kanaya/Pineapple_II_Nitrogen/Hardware/Panel/Takachi-Order-Sheet.pdf

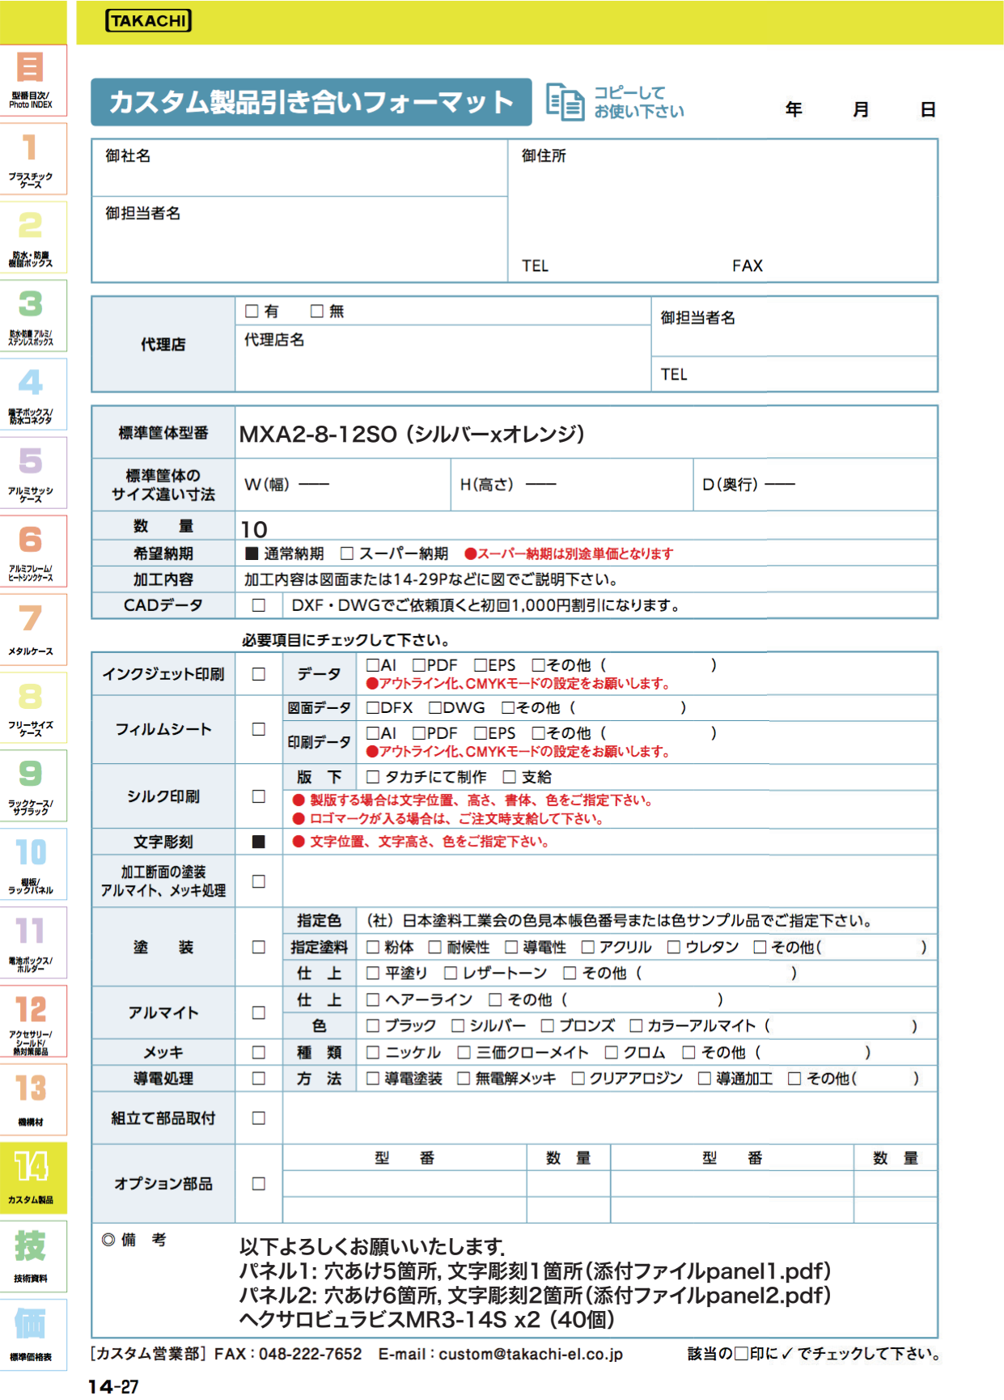
[picture p1: page 1]

MXA2-8-12SO （シルバーxオレンジ）

10

––– | ––– | –––

以下よろしくお願いいたします．
パネル1: 穴あけ5箇所，文字彫刻1箇所（添付ファイルpanel1.pdf） パネル2: 穴あけ6箇所，文字彫刻2箇所（添付ファイルpanel2.pdf） ヘクサロビュラビスMR3-14S x2 （40個）
