kanaya/Pineapple_II_Nitrogen/Hardware/Panel/panel-layout.pdf

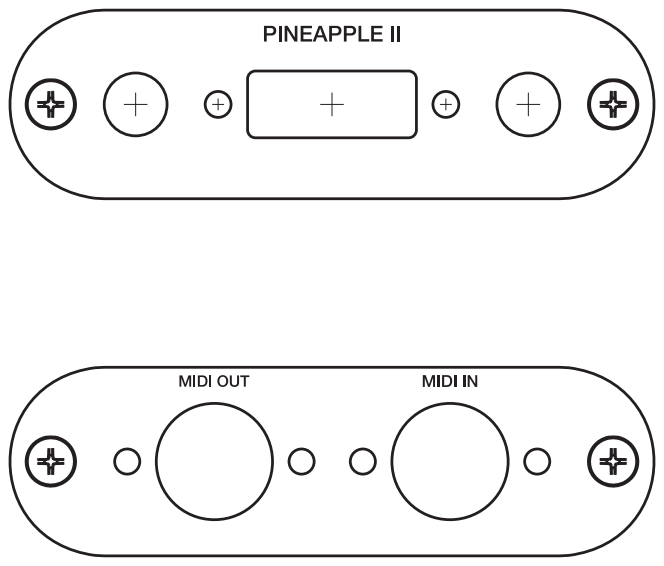
[picture p2: page 1]
