kanaya/Pineapple_II_Nitrogen/Hardware/Panel/panel1.pdf

## BLACK

## PANEL 1

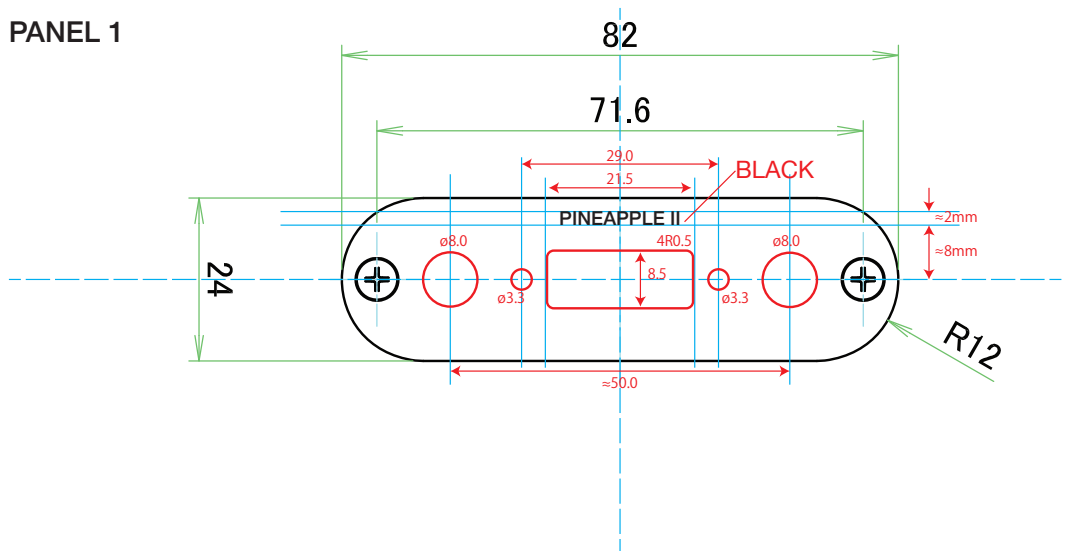
[picture p3: page 1]
PINEAPPLE II
