kanaya/Pineapple_II_Nitrogen/Hardware/Panel/panel2.pdf

BLACK | BLACK

## PANEL 2

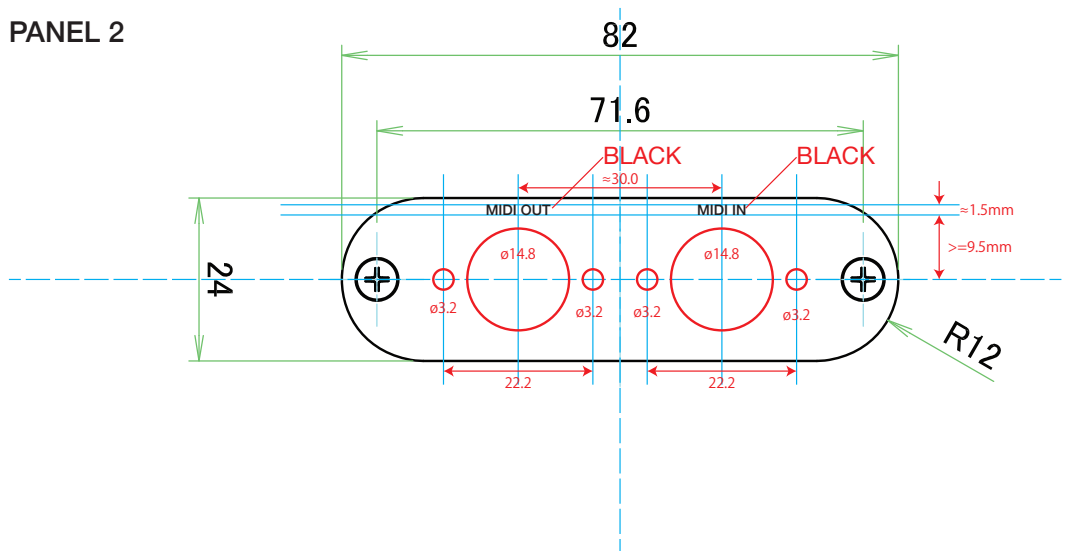
[picture p4: page 1]
MIDI OUT; MIDI IN
