kanaya/Pineapple_II_Nitrogen/Hardware/Board/P2N-001.brd

## EAGLE design Hardware/Board/P2N-001.brd (2015-04-24)

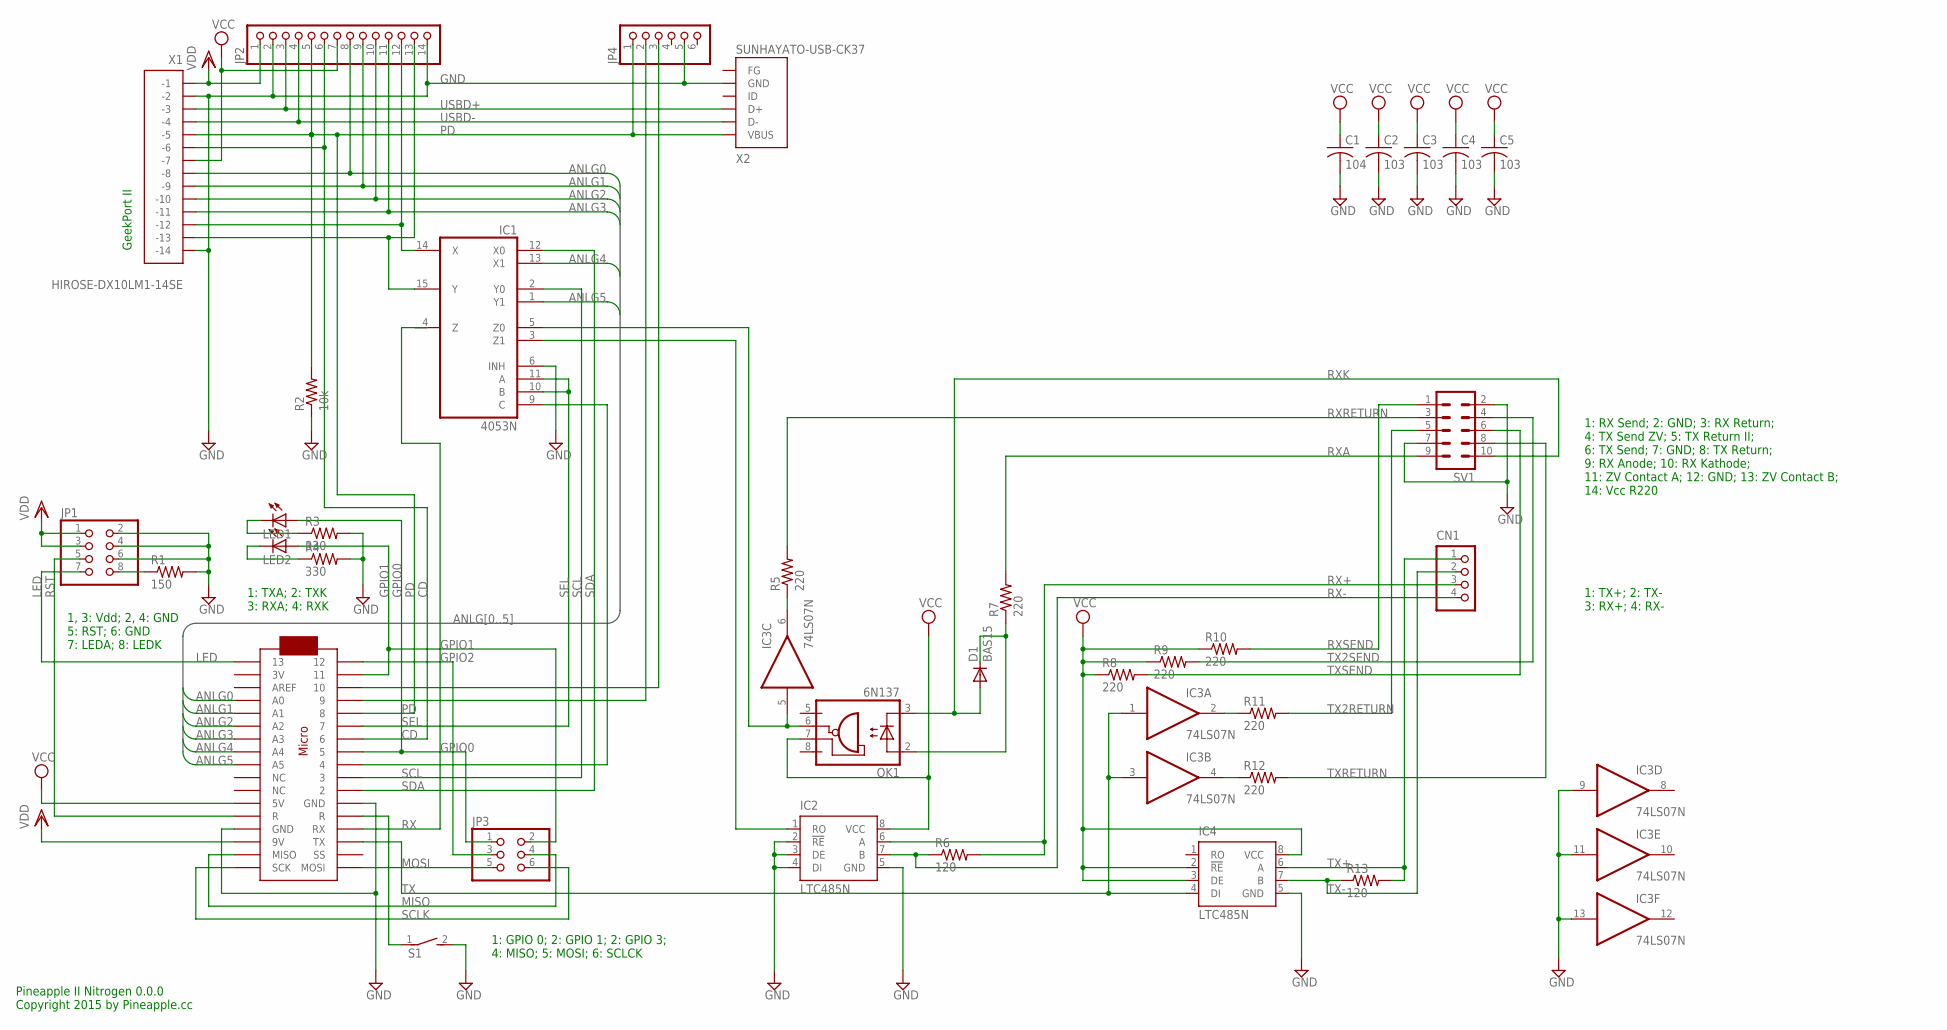
[picture p5: schematic P2N-001.sch]

Parts:
C1: 104; C025-025X050
C2, C3, C4, C5: 103; C025-025X050
CN1: S4B-PH-K-S
D1: BAS15; DO34-7
IC1: 4053N; DIL16
IC2, IC4: LTC485N; DIL08
IC3: 74LS07N; DIL14
JP1: PINHD-2X4; 2X04
JP2: PINHD-1X14-CB; 1X14-CB
JP3: PINHD-2X3; 2X03
JP4: PINHD-1X6; 1X06
LED1, LED2: LED3MM
MC1: ARDUINOMICRO
OK1: 6N137; DIL08
R1: 150; 0204/5
R2: 10k; 0204/5
R3, R4: 330; 0204/5
R5, R7, R8, R9, R10, R11, R12: 220; 0204/5
R6, R13: 120; 0204/5
S1: DS01E; DS-01
SV1: ML10L
X1: HIROSE-DX10LM1-14SE
X2: SUNHAYATO-USB-CK37

Connections:
ANLG0: JP2.8, MC1.P$31 (A0), X1.P$8 (-8)
ANLG1: JP2.9, MC1.P$30 (A1), X1.P$9 (-9)
ANLG2: JP2.10, MC1.P$29 (A2), X1.P$10 (-10)
ANLG3: JP2.11, MC1.P$28 (A3), X1.P$11 (-11)
ANLG4: IC1.13 (X1), MC1.P$27 (A4)
ANLG5: IC1.1 (Y1), MC1.P$26 (A5)
CD: JP2.6, MC1.P$7 (6), X1.P$6 (-6)
GND: C1.2, C2.2, C3.2, C4.2, C5.2, IC1.6 (INH), IC1.8 (GND), IC2.2 (!RE), IC2.3 (DE), IC2.4 (DI), IC2.5 (GND), IC3.7 (GND), IC3.9 (I), IC3.11 (I), IC3.13 (I), IC4.5 (GND), JP1.2, JP1.4, JP1.6, JP2.2, JP2.14, JP4.5, MC1.P$12 (GND), MC1.P$21 (GND), R1.2, R2.1, R3.2, R4.2, S1.2, SV1.2, SV1.7, X1.P$2 (-2), X1.P$14 (-14), X2.P$5 (GND)
GPIO0: JP3.1, LED1.A, MC1.P$8 (5)
GPIO1: JP3.2, LED2.A, MC1.P$2 (11)
GPIO2: JP3.3, MC1.P$1 (12)
LED: JP1.7, MC1.P$34 (13)
MIDIRX: IC1.5 (Z0), IC3.5 (I), OK1.6 (VO)
MISO: JP3.4, MC1.P$19 (MISO)
MOSI: JP3.5, MC1.P$17 (MOSI)
unnamed: MC1.P$22 (R), S1.1
unnamed: IC3.2 (O), R11.1
unnamed: IC3.6 (O), R5.1
unnamed: IC3.4 (O), R12.1
unnamed: JP4.2, MC1.P$4 (9)
unnamed: JP4.3, MC1.P$3 (10)
unnamed: IC1.9 (C), MC1.P$9 (4)
unnamed: D1.C, OK1.2 (A), R7.1
unnamed: LED1.K (C), R3.1
unnamed: LED2.K (C), R4.1
unnamed: IC1.14 (X), JP2.12, X1.P$12 (-12)
unnamed: IC1.15 (Y), JP2.13, X1.P$13 (-13)
unnamed: JP1.8, R1.1
PD: JP2.5, JP4.1, MC1.P$5 (8), R2.2, X1.P$5 (-5), X2.P$1 (VBUS)
RST: JP1.5, MC1.P$13 (R)
RX: MC1.P$14 (RX)
RX+: CN1.3, IC2.6 (A), R6.2
RX-: CN1.4, IC2.7 (B), R6.1
RXA: R7.2, SV1.9
RXK: D1.A, OK1.3 (C), SV1.10
RXRETURN: R5.2, SV1.3
RXSEND: R10.2, SV1.1
SCL: IC1.2 (Y0), MC1.P$10 (3)
SCLK: JP3.6, MC1.P$18 (SCK)
SDA: IC1.12 (X0), MC1.P$11 (2)
SEL: IC1.10 (B), IC1.11 (A), MC1.P$6 (7)
TX: IC3.1 (I), IC3.3 (I), IC4.4 (DI), MC1.P$15 (TX)
TX2RETURN: R11.2, SV1.5
TX2SEND: R9.2, SV1.4
TX+: CN1.1, IC4.6 (A), R13.2
TX-: CN1.2, IC4.7 (B), R13.1
TXRETURN: R12.2, SV1.8
TXSEND: R8.2, SV1.6
USBD+: JP2.3, X1.P$3 (-3), X2.P$3 (D+)
USBD-: JP2.4, X1.P$4 (-4), X2.P$2 (D-)
VCC: C1.1, C2.1, C3.1, C4.1, C5.1, IC1.16 (VCC), IC2.8 (VCC), IC3.14 (VCC), IC4.2 (!RE), IC4.3 (DE), IC4.8 (VCC), JP2.7, MC1.P$23 (5V), OK1.7 (VE), R8.1, R9.1, R10.1, X1.P$7 (-7)
VDD: JP1.1, JP1.3, JP2.1, MC1.P$20 (9V), X1.P$1 (-1)
VEE: IC1.7 (VEE)
XMIDIRX: IC1.3 (Z1), IC2.1 (RO)

Notes on the sheet:
Pineapple II Nitrogen 0.0.0 Copyright 2015 by Pineapple.cc
1, 3: Vdd; 2, 4: GND 5: RST; 6: GND 7: LEDA; 8: LEDK
GeekPort II
1: TXA; 2: TXK 3: RXA; 4: RXK
1: TX+; 2: TX- 3: RX+; 4: RX-
1: GPIO 0; 2: GPIO 1; 2: GPIO 3; 4: MISO; 5: MOSI; 6: SCLCK
1: RX Send; 2: GND; 3: RX Return; 4: TX Send ZV; 5: TX Return II; 6: TX Send; 7: GND; 8: TX Return; 9: RX Anode; 10: RX Kathode; 11: ZV Contact A; 12: GND; 13: ZV Contact B; 14: Vcc R220

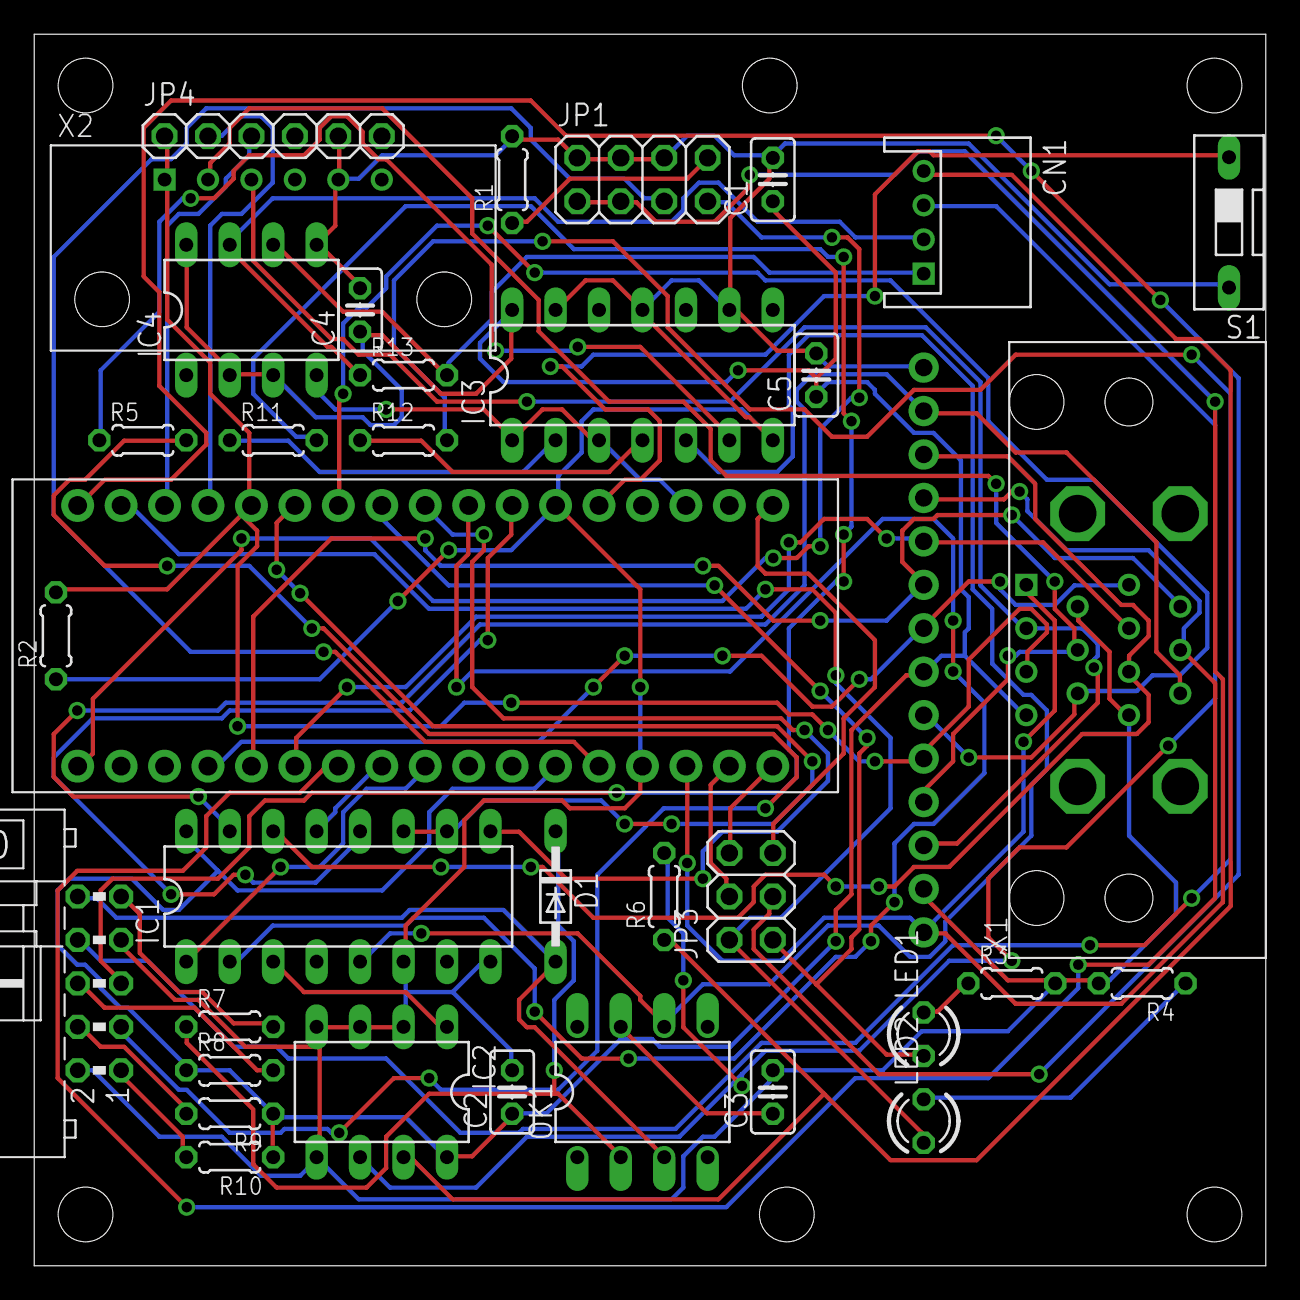
[picture p6: board P2N-001.brd from above]

Board: 2 copper layers, 72.0 x 72.0 mm, 36 parts (0 on the bottom side), 52 nets.
