kanaya/Pineapple_II_Nitrogen/Hardware/Board/P2N15-001.brd

## EAGLE design Hardware/Board/P2N15-001.brd (2015-04-24)

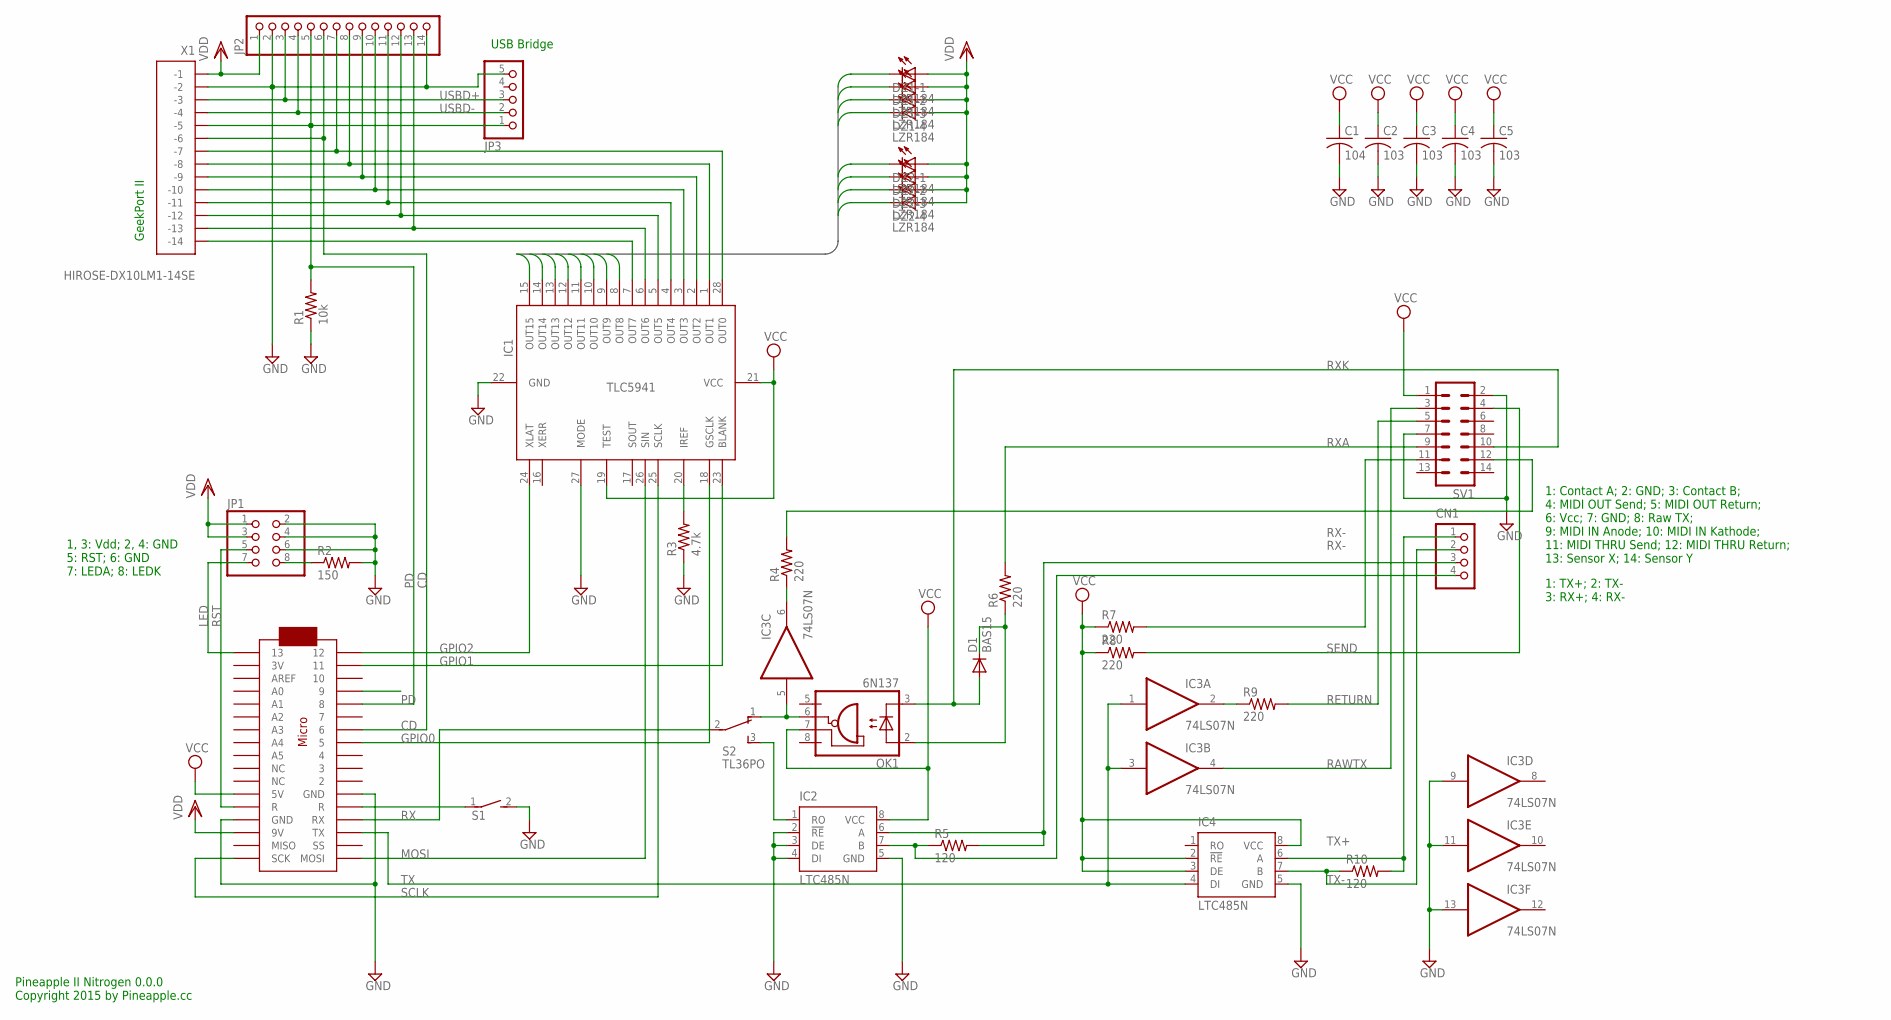
[picture p7: schematic P2N15-001.sch]

Parts:
C1: 104; C025-025X050
C2, C3, C4, C5: 103; C025-025X050
CN1: S4B-PH-K-S
D1: BAS15; DO34-7
DZ1, DZ2: LZR184
IC1: TLC5941NT; DIL28-3
IC2, IC4: LTC485N; DIL08
IC3: 74LS07N; DIL14
JP1: PINHD-2X4; 2X04
JP2: PINHD-1X14; 1X14
JP3: PINHD-1X5/90; 1X05/90
MC1: ARDUINOMICRO
OK1: 6N137; DIL08
R1: 10k; 0204/5
R2: 150; 0204/5
R3: 4.7k; 0204/5
R4, R6, R7, R8, R9: 220; 0204/5
R5, R10: 120; 0204/5
S1: DS01E; DS-01
S2: TL36PO; TL3XPO
SV1: ML14L
X1: HIROSE-DX10LM1-14SE

Connections:
ANLG0: IC1.1 (OUT1), JP2.8, X1.P$8 (-8)
ANLG1: IC1.2 (OUT2), JP2.9, X1.P$9 (-9)
ANLG2: IC1.3 (OUT3), JP2.10, X1.P$10 (-10)
ANLG3: IC1.4 (OUT4), JP2.11, X1.P$11 (-11)
CD: JP2.6, MC1.P$7 (6), X1.P$6 (-6)
GND: C1.2, C2.2, C3.2, C4.2, C5.2, IC1.22 (GND), IC1.27 (MODE), IC2.2 (!RE), IC2.3 (DE), IC2.4 (DI), IC2.5 (GND), IC3.7 (GND), IC3.9 (I), IC3.11 (I), IC3.13 (I), IC4.5 (GND), JP1.2, JP1.4, JP1.6, JP2.2, JP2.14, JP3.5, MC1.P$12 (GND), MC1.P$21 (GND), R1.1, R2.2, R3.1, S1.2, SV1.2, SV1.7, X1.P$2 (-2)
GPIO0: IC1.18 (GSCLK), MC1.P$8 (5)
GPIO1: IC1.23 (BLANK), MC1.P$2 (11)
GPIO2: IC1.24 (XLAT), MC1.P$1 (12)
LED: JP1.7, MC1.P$34 (13)
LED0: DZ1.K1 (C), IC1.8 (OUT8)
LED1: DZ1.K2 (C), IC1.9 (OUT9)
LED2: DZ1.K3 (C), IC1.10 (OUT10)
LED3: DZ1.K4 (C), IC1.11 (OUT11)
LED4: DZ2.K1 (C), IC1.12 (OUT12)
LED5: DZ2.K2 (C), IC1.13 (OUT13)
LED6: DZ2.K3 (C), IC1.14 (OUT14)
LED7: DZ2.K4 (C), IC1.15 (OUT15)
MIDIRX: IC3.5 (I), OK1.6 (VO), S2.1 (O)
MOSI: IC1.26 (SIN), MC1.P$17 (MOSI)
unnamed: IC1.28 (OUT0), JP2.7, X1.P$7 (-7)
unnamed: IC3.2 (O), R9.1
unnamed: IC1.20 (IREF), R3.2
unnamed: MC1.P$22 (R), S1.1
unnamed: IC3.6 (O), R4.1
unnamed: R7.2, SV1.11
unnamed: IC1.7 (OUT7), X1.P$14 (-14)
unnamed: R4.2, SV1.12
unnamed: D1.C, OK1.2 (A), R6.1
unnamed: IC1.5 (OUT5), JP2.12, X1.P$12 (-12)
unnamed: IC1.6 (OUT6), JP2.13, X1.P$13 (-13)
unnamed: JP1.8, R2.1
PD: JP2.5, JP3.1, MC1.P$5 (8), R1.2, X1.P$5 (-5)
RAWTX: IC3.4 (O), SV1.3
RETURN: R9.2, SV1.5
RST: JP1.5, MC1.P$13 (R)
RX: MC1.P$14 (RX), S2.2
RX+: CN1.3, IC2.6 (A), R5.2
RX-: CN1.4, IC2.7 (B), R5.1
RXA: R6.2, SV1.9
RXK: D1.A, OK1.3 (C), SV1.10
SCLK: IC1.25 (SCLK), MC1.P$18 (SCK)
SEND: R8.2, SV1.4
TX: IC3.1 (I), IC3.3 (I), IC4.4 (DI), MC1.P$15 (TX)
TX+: CN1.1, IC4.6 (A), R10.2
TX-: CN1.2, IC4.7 (B), R10.1
USBD+: JP2.3, JP3.3, X1.P$3 (-3)
USBD-: JP2.4, JP3.2, X1.P$4 (-4)
VCC: C1.1, C2.1, C3.1, C4.1, C5.1, IC1.19 (TEST), IC1.21 (VCC), IC2.8 (VCC), IC3.14 (VCC), IC4.2 (!RE), IC4.3 (DE), IC4.8 (VCC), MC1.P$23 (5V), OK1.7 (VE), R7.1, R8.1, SV1.1
VDD: DZ1.A1 (A), DZ1.A2 (A), DZ1.A3 (A), DZ1.A4 (A), DZ2.A1 (A), DZ2.A2 (A), DZ2.A3 (A), DZ2.A4 (A), JP1.1, JP1.3, JP2.1, MC1.P$20 (9V), X1.P$1 (-1)
XMIDIRX: IC2.1 (RO), S2.3 (S)

Notes on the sheet:
Pineapple II Nitrogen 0.0.0 Copyright 2015 by Pineapple.cc
1, 3: Vdd; 2, 4: GND 5: RST; 6: GND 7: LEDA; 8: LEDK
GeekPort II
USB Bridge
1: TX+; 2: TX- 3: RX+; 4: RX-
1: Contact A; 2: GND; 3: Contact B; 4: MIDI OUT Send; 5: MIDI OUT Return; 6: Vcc; 7: GND; 8: Raw TX; 9: MIDI IN Anode; 10: MIDI IN Kathode; 11: MIDI THRU Send; 12: MIDI THRU Return; 13: Sensor X; 14: Sensor Y

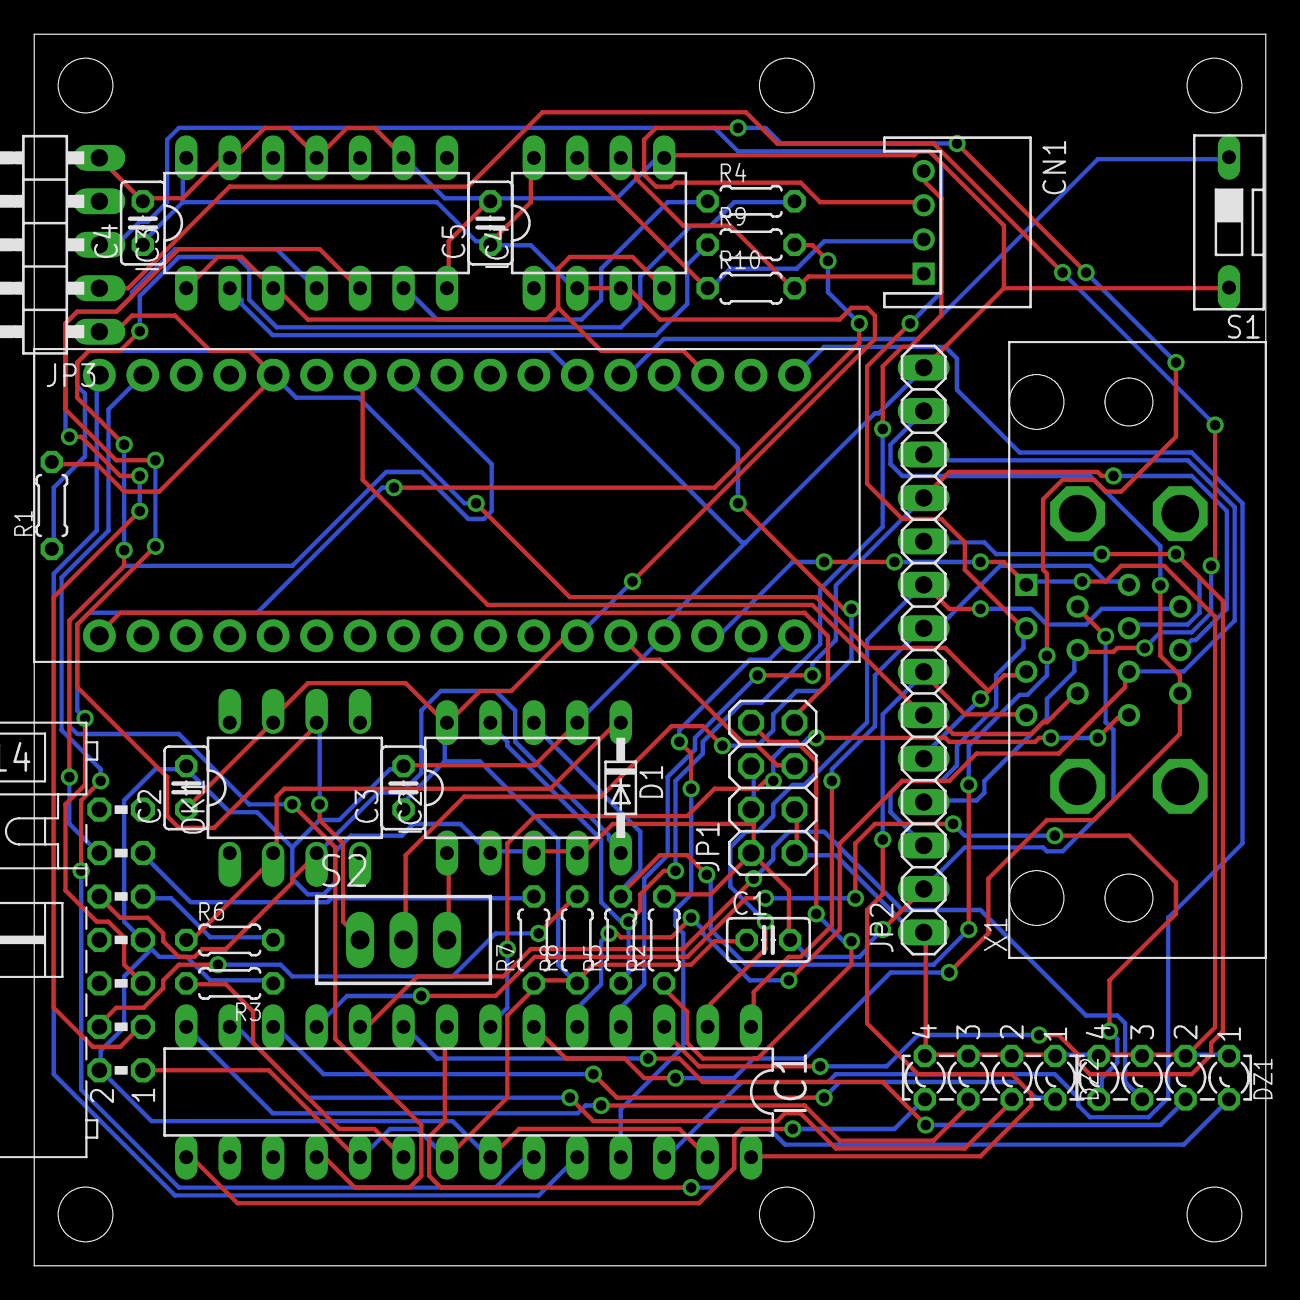
[picture p8: board P2N15-001.brd from above]

Board: 2 copper layers, 72.0 x 72.0 mm, 32 parts (0 on the bottom side), 51 nets.
