kanaya/Pineapple_II_Nitrogen/Hardware/Board/P2N-002.brd

## EAGLE design Hardware/Board/P2N-002.brd (2015-04-14)

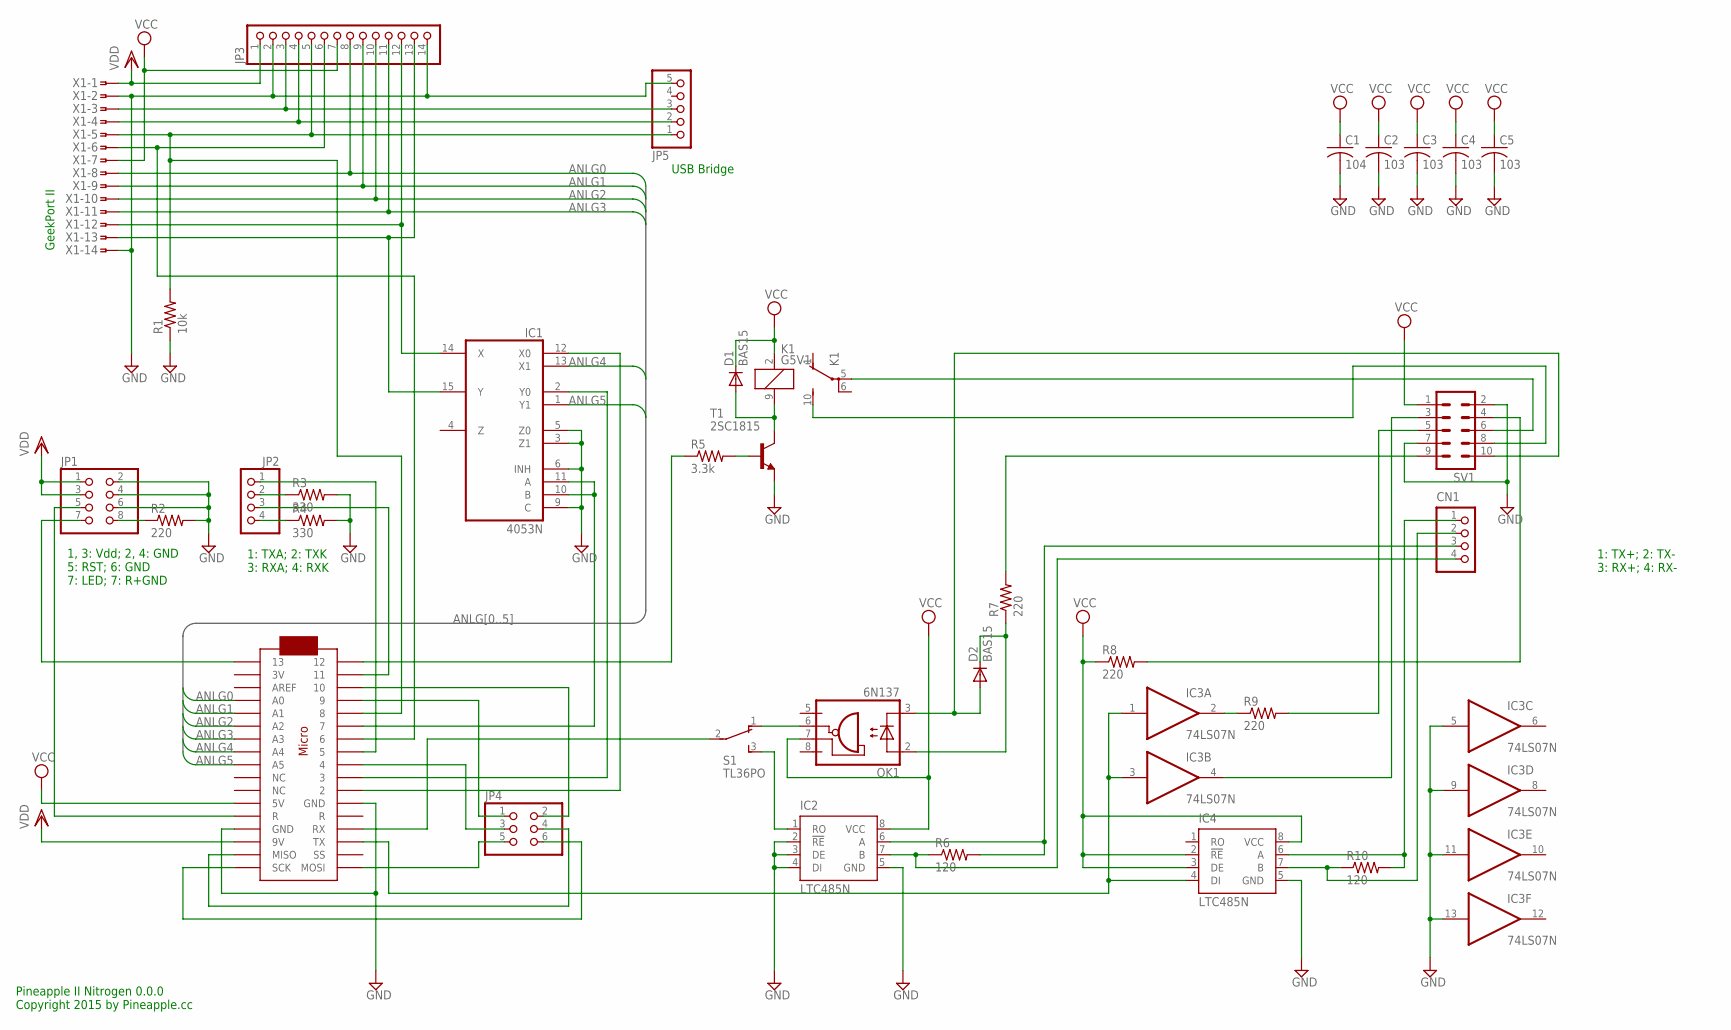
[picture p9: schematic P2N-002.sch]

Parts:
C1: 104; C025-025X050
C2, C3, C4, C5: 103; C025-025X050
CN1: S4B-PH-K-S
D1, D2: BAS15; DO34-7
IC1: 4053N; DIL16
IC2, IC4: LTC485N; DIL08
IC3: 74LS07N; DIL14
JP1: PINHD-2X4; 2X04
JP2: PINHD-1X4; 1X04
JP3: PINHD-1X14; 1X14
JP4: PINHD-2X3; 2X03
JP5: PINHD-1X5/90; 1X05/90
K1: G5V1
MC1: ARDUINOMICRO
OK1: 6N137; DIL08
R1: 10k; 0204/5
R2, R7, R8, R9: 220; 0204/5
R3, R4: 330; 0204/5
R5: 3.3k; 0204/5
R6, R10: 120; 0204/5
S1: TL36PO; TL3XPO
SV1: ML10L
T1: 2SC1815; TO92-ECB
X1: HIROSE-DXLM

Connections:
ANLG0: JP3.8, MC1.P$31 (A0), X1.8
ANLG1: JP3.9, MC1.P$30 (A1), X1.9
ANLG2: JP3.10, MC1.P$29 (A2), X1.10
ANLG3: JP3.11, MC1.P$28 (A3), X1.11
ANLG4: IC1.13 (X1), MC1.P$27 (A4)
ANLG5: IC1.1 (Y1), MC1.P$26 (A5)
GEEK16: IC1.10 (B), IC1.11 (A), MC1.P$6 (7)
GND: C1.2, C2.2, C3.2, C4.2, C5.2, IC1.3 (Z1), IC1.5 (Z0), IC1.6 (INH), IC1.8 (GND), IC1.9 (C), IC2.2 (!RE), IC2.3 (DE), IC2.4 (DI), IC2.5 (GND), IC3.5 (I), IC3.7 (GND), IC3.9 (I), IC3.11 (I), IC3.13 (I), IC4.5 (GND), JP1.2, JP1.4, JP1.6, JP3.2, JP3.14, JP5.5, MC1.P$12 (GND), MC1.P$21 (GND), R1.1, R2.2, R3.2, R4.2, SV1.2, SV1.7, T1.E, X1.2, X1.14
MIDI1: CN1.1, IC4.6 (A), R10.2
MIDI3: CN1.2, IC4.7 (B), R10.1
MIDI6: IC3.1 (I), IC3.3 (I), IC4.4 (DI), MC1.P$15 (TX)
MIDI11: CN1.3, IC2.6 (A), R6.2
MIDI13: CN1.4, IC2.7 (B), R6.1
MIDI15: D2.A, OK1.3 (C), SV1.10
MIDIRX: OK1.6 (VO), S1.1 (O)
unnamed: IC3.4 (O), SV1.3
unnamed: IC3.2 (O), R9.1
unnamed: JP1.5, MC1.P$13 (R)
unnamed: JP1.7, MC1.P$34 (13)
unnamed: R7.2, SV1.9
unnamed: D1.A, K1.9 (2), T1.C
unnamed: MC1.P$14 (RX), S1.2
unnamed: R5.2, T1.B
unnamed: JP4.3, MC1.P$9 (4)
unnamed: R9.2, SV1.5
unnamed: JP4.5, MC1.P$17 (MOSI)
unnamed: R8.2, SV1.4
unnamed: JP4.6, MC1.P$18 (SCK)
unnamed: K1.10 (S), SV1.8
unnamed: D2.C, OK1.2 (A), R7.1
unnamed: K1.5, SV1.6
unnamed: JP2.2, R3.1
unnamed: JP2.4, R4.1
unnamed: IC1.2 (Y0), MC1.P$10 (3)
unnamed: JP2.1, MC1.P$8 (5)
unnamed: JP2.3, MC1.P$2 (11)
unnamed: MC1.P$1 (12), R5.1
unnamed: IC1.12 (X0), MC1.P$11 (2)
unnamed: JP3.5, JP5.1, MC1.P$5 (8), R1.2, X1.5
unnamed: JP3.4, JP5.2, X1.4
unnamed: JP3.3, JP5.3, X1.3
unnamed: JP3.6, MC1.P$7 (6), X1.6
unnamed: IC1.14 (X), JP3.12, X1.12
unnamed: IC1.15 (Y), JP3.13, X1.13
unnamed: JP4.1, MC1.P$4 (9)
unnamed: JP4.2, MC1.P$3 (10)
unnamed: JP1.8, R2.1
unnamed: JP4.4, MC1.P$19 (MISO)
VCC: C1.1, C2.1, C3.1, C4.1, C5.1, D1.C, IC1.16 (VCC), IC2.8 (VCC), IC3.14 (VCC), IC4.2 (!RE), IC4.3 (DE), IC4.8 (VCC), JP3.7, K1.2 (1), MC1.P$23 (5V), OK1.7 (VE), R8.1, SV1.1, X1.7
VDD: JP1.1, JP1.3, JP3.1, MC1.P$20 (9V), X1.1
VEE: IC1.7 (VEE)
XMIDIRX: IC2.1 (RO), S1.3 (S)

Notes on the sheet:
Pineapple II Nitrogen 0.0.0 Copyright 2015 by Pineapple.cc
1, 3: Vdd; 2, 4: GND 5: RST; 6: GND 7: LED; 7: R+GND
GeekPort II
USB Bridge
1: TXA; 2: TXK 3: RXA; 4: RXK
1: TX+; 2: TX- 3: RX+; 4: RX-

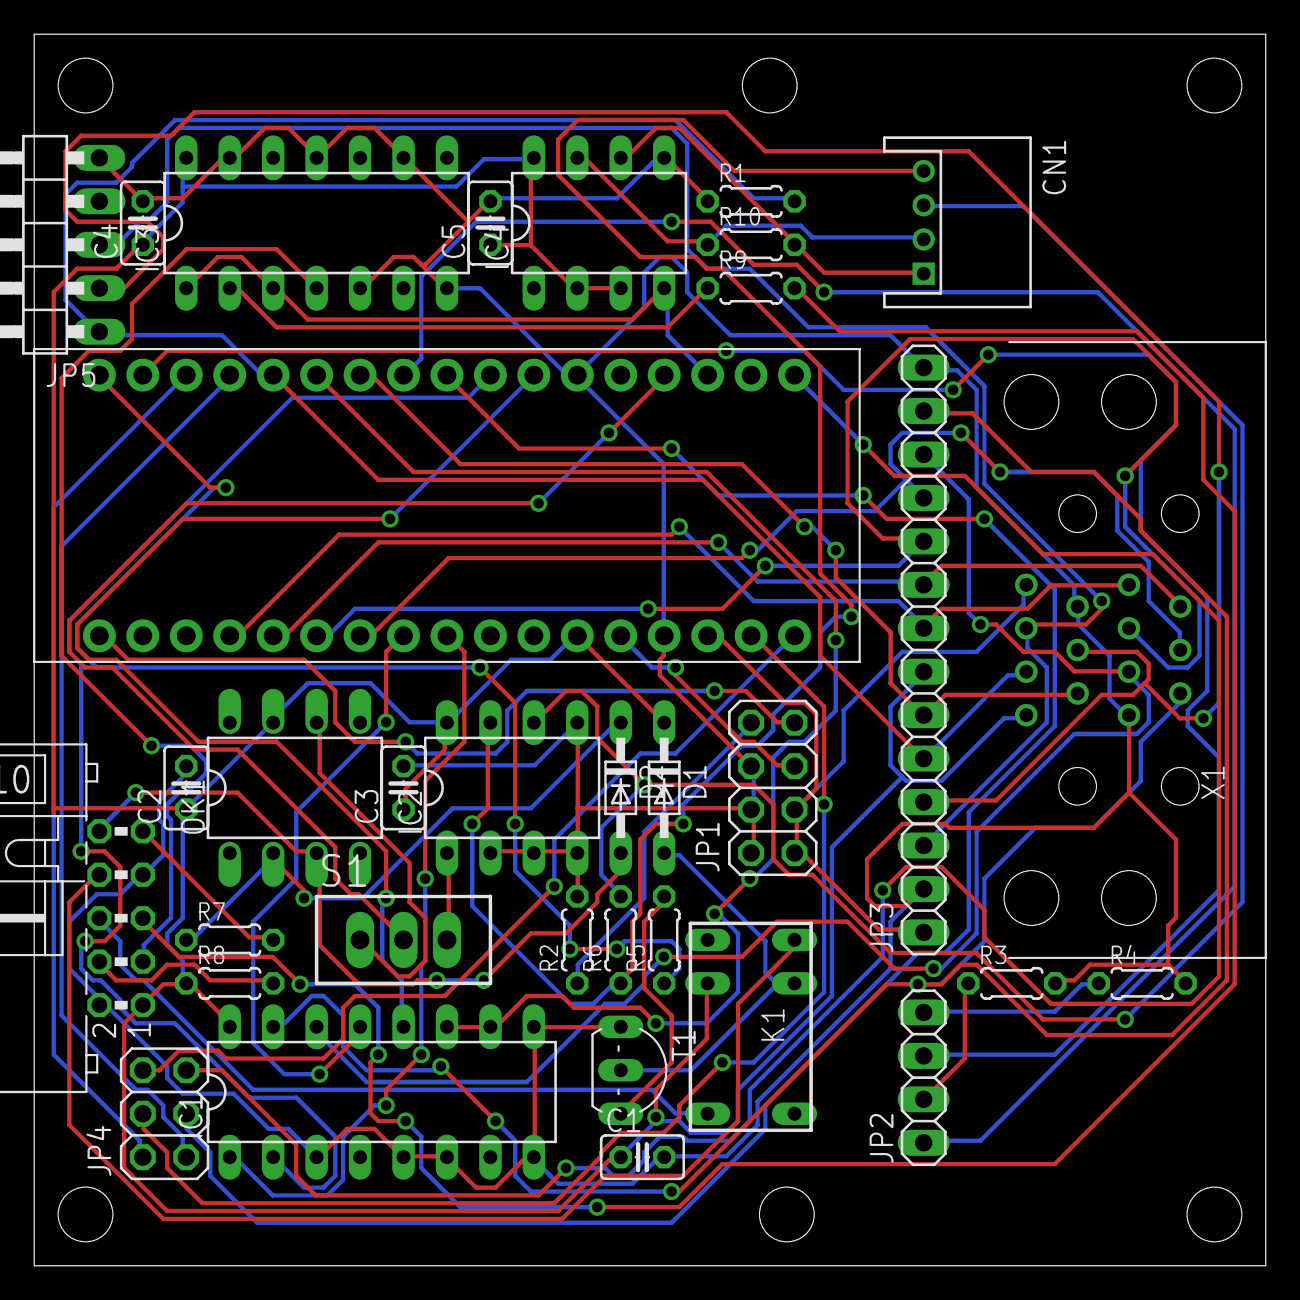
[picture p10: board P2N-002.brd from above]

Board: 2 copper layers, 72.0 x 72.0 mm, 34 parts (0 on the bottom side), 51 nets.
