kanaya/Pineapple_II_Nitrogen/(commit log)

2015-04-05 Added Hardware/Board.
    [P2N-001.brd, P2N-001.sch]
2015-04-08 Some pinouts were replaced.
    [P2N-001.brd, P2N-001.sch]
2015-04-08 New board design.
    [P2N-001.brd, P2N-001.sch]
2015-04-08 PH straight -> PH bended.
    [P2N-001.brd, P2N-001.sch]
2015-04-08 Rerouted the board.
    [P2N-001.brd]
2015-04-13 Fixed something.
    [P2N-001.brd]
2015-04-13 New circuit design. (Experimental.)
    [P2N-002.brd, P2N-002.sch]
2015-04-13 New pinout.
    [P2N-001.brd, P2N-001.sch]
2015-04-13 Canceled change of XMIDI layout.
    [P2N-001.brd, P2N-001.sch]
2015-04-13 New layout.
    [P2N-002.brd, P2N-002.sch]
2015-04-14 Changed MIDI IN/OUT layout.
    [P2N-002.brd, P2N-002.sch]
2015-04-14 Internal drive port.
    [P2N-002.brd, P2N-002.sch]
2015-04-14 Removed P2N-001.{brd,sch}.
    [P2N-001.brd, P2N-001.sch]
2015-04-14 Renamed P2N-002.{brd,sch} to P2N-001.{brd,sch}.
    [P2N-001.brd, P2N-001.sch]
2015-04-14 Update document.
    [P2N-001.brd]
2015-04-14 Added comment.
    [P2N-001.sch]
2015-04-14 Modified pinout.
    [P2N-001.brd, P2N-001.sch]
2015-04-14 Labeled wires.
    [P2N-001.brd, P2N-001.sch]
2015-04-15 Added anther LED pattern.
    [P2N-001.brd, P2N-001.sch]
2015-04-15 No change.
    [P2N-001.brd]
2015-04-15 Removed LED jumper.
    [P2N-001.brd, P2N-001.sch]
2015-04-16 Added N15.
    [P2N15-001.brd, P2N15-001.sch]
2015-04-16 Attached LED pattern to GPIO pins.
    [P2N15-001.brd, P2N15-001.sch]
2015-04-16 Cleaned up schematic and board design of P2N.
    [P2N-001.brd, P2N-001.sch]
2015-04-17 Added LED monitors to P2N15.
    [P2N15-001.brd, P2N15-001.sch]
2015-04-17 Added Reset SW.
    [P2N-001.brd, P2N-001.sch, P2N15-001.brd, P2N15-001.sch]
2015-04-17 Added MIDI THRU function.
    [P2N-001.brd, P2N-001.sch, P2N15-001.brd, P2N15-001.sch]
2015-04-18 Updated Hirose DX10LM1-14SE connector pattern.
    [P2N-001.brd, P2N-001.sch, P2N15-001.brd, P2N15-001.sch]
2015-04-21 Changed R value of main LED (from 220 to 150 ohm).
    [P2N-001.brd, P2N-001.sch, P2N15-001.brd, P2N15-001.sch]
2015-04-22 Changed 10p-backport to 14p-backport.
    [P2N-001.brd, P2N-001.sch, P2N15-001.brd, P2N15-001.sch]
2015-04-22 Adopted to XMIDI.
    [P2N-001.brd, P2N-001.sch]
2015-04-22 Cleaned up board design.
    [P2N-001.brd, P2N-001.sch]
2015-04-23 Changed USB connector from Pinheader to Micro-B.
    [P2N-001.brd, P2N-001.sch]
2015-04-23 Changed USB con to Sunhayatos connector board. Changed USB connector to Sunhayato's connector board. Also removed ZeroVoltage function.
    [P2N-001.brd, P2N-001.sch]
